foqhn/ekagaku_gritcat/ローバー側　セットアップ方法.md

python packages
```bash

```

ros package
```

```

shell command
```bash
sudo apt install wireless-tools

```
