foqhn/ekagaku_gritcat/説明用/Gritcat_1.0 セットアップ方法.md

## 1. 準備 
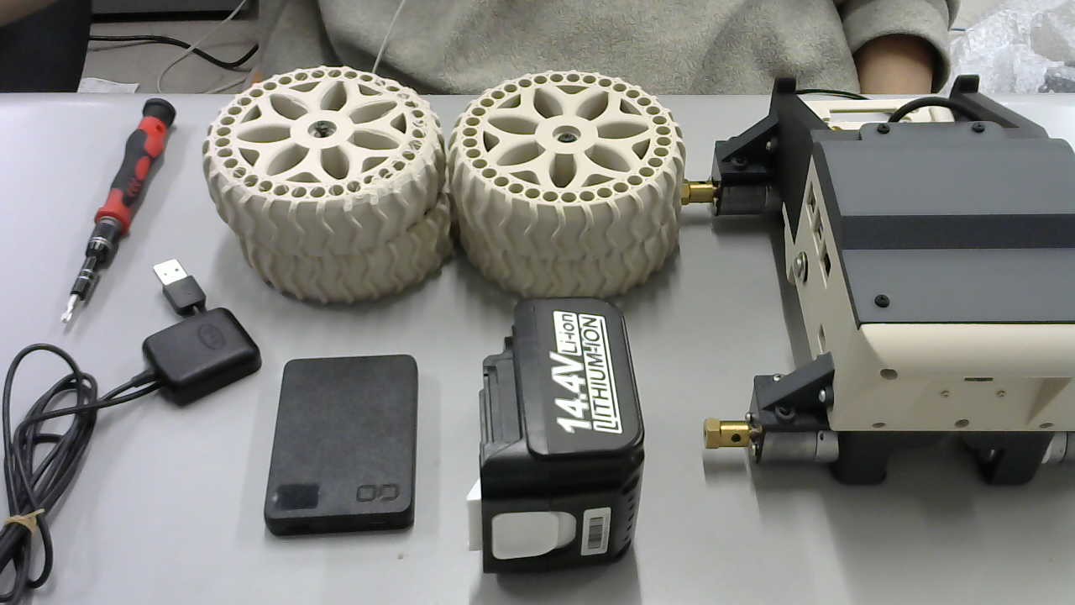
[picture p1: 説明用/images/setup.jpg]

	内容物</br>
	- 本体</br>
	- ホイール x4</br>
	- M4ネジ x4</br>
	- ワッシャー x4</br>
	- マキタ互換バッテリー</br>
	- CIOモバイルバッテリー</br>
	- GPS USBタイプ</br>
	組み立てに必要なもの</br>
	- M4プラスドライバー</br>
	- (M2.5 6角)</br>
## 2. モバイルバッテリーの挿入
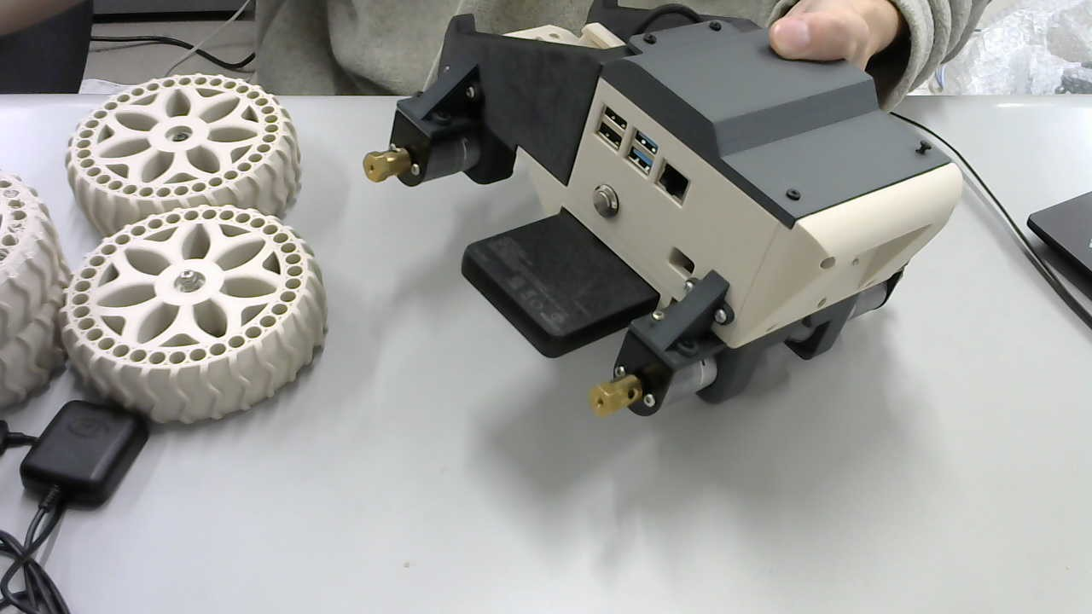
[picture p2: 説明用/images/insert_mob_batt.jpg]

	下のスペースにモバイルバッテリーを**下向きに**挿入する．
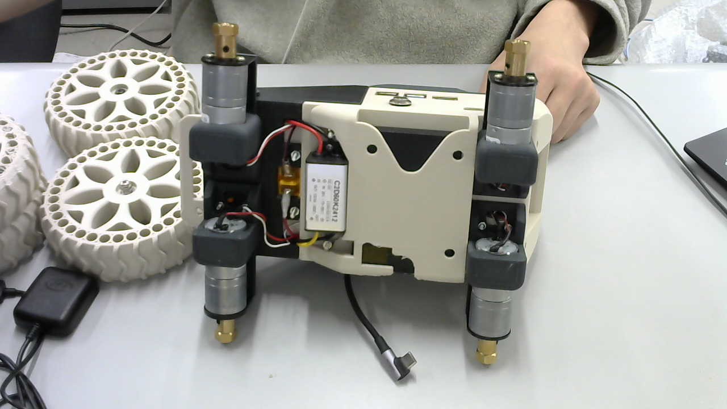
[picture p3: 説明用/images/monitor.jpg]

	バッテリー容量が確認できるモニターがちょうど見えるようになるはず．
## 3. ホイールの取付
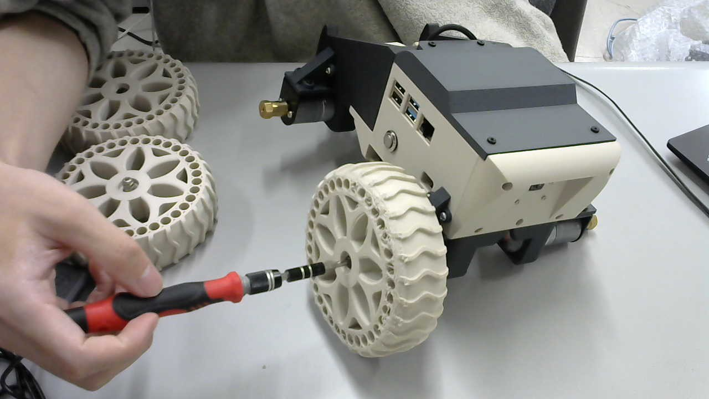
[picture p4: 説明用/images/screw.jpg]

	ネジの頭とホイールの間にワッシャーを挟む
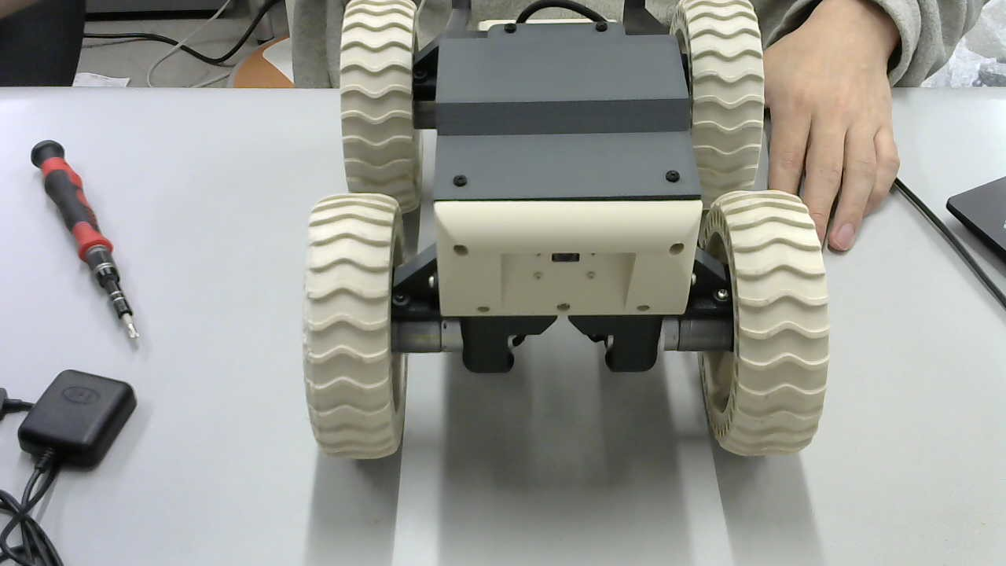
[picture p5: 説明用/images/4wheel.jpg]

	左右でホイールのパターンをそろえたほうがいい
## 4. GPSの取付
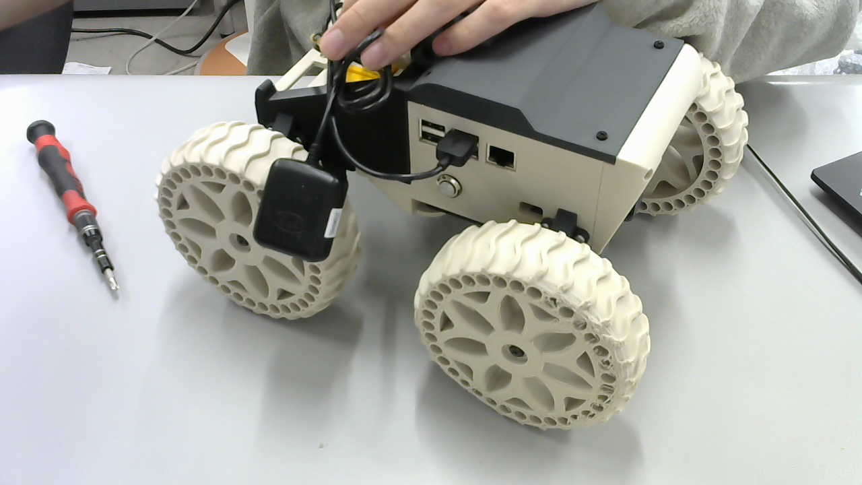
[picture p6: 説明用/images/gps.jpg]

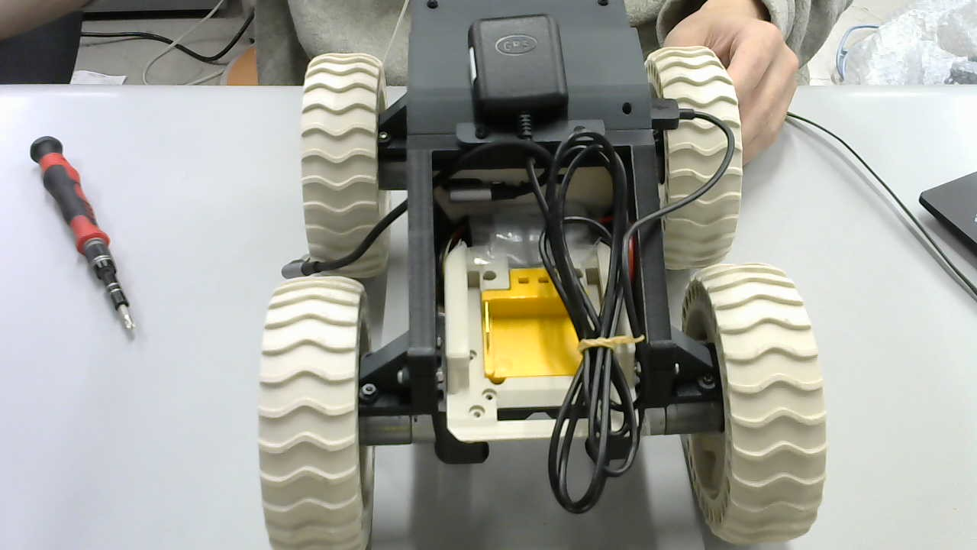
[picture p7: 説明用/images/bind_gps.jpg]

	現状GPSの取付スペースがないので，ケーブルの間に通して固定する
## 5. モーター用バッテリーの挿入
	挿入の前に，本体側面の**ボタンが押下されていない**ことを確認
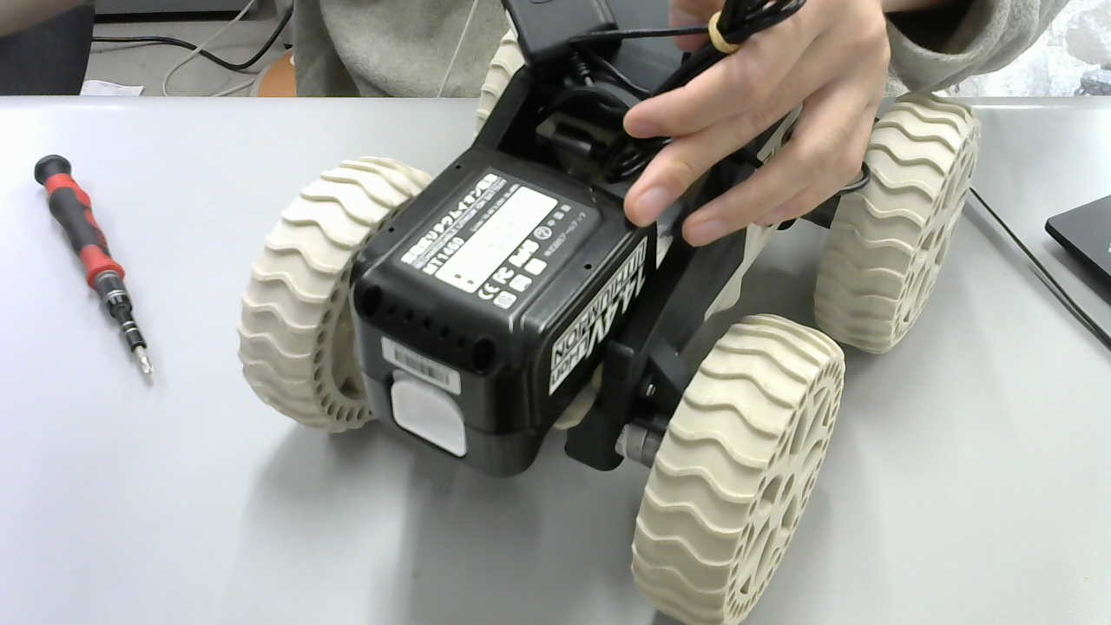
[picture p8: 説明用/images/ins_batt.jpg]

	バッテリーの溝に合わせてスライドするように挿入する．
	カチッと言うまでバッテリーを押し込む．
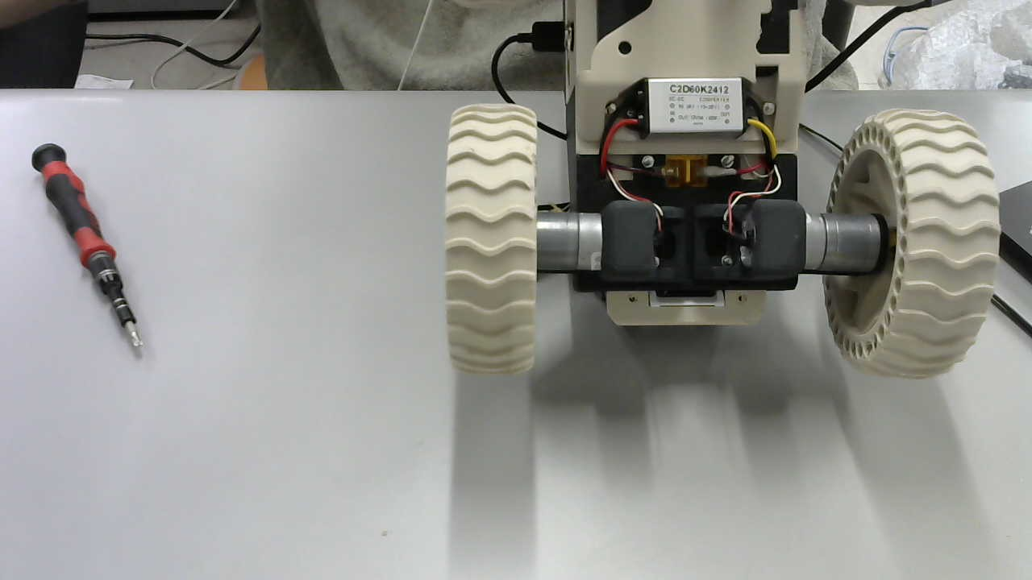
[picture p9: 説明用/images/batt_lock.jpg]

	白い部分がバッテリー取付スペースの穴から完全に出れば固定できている．
## 6. 電源投入
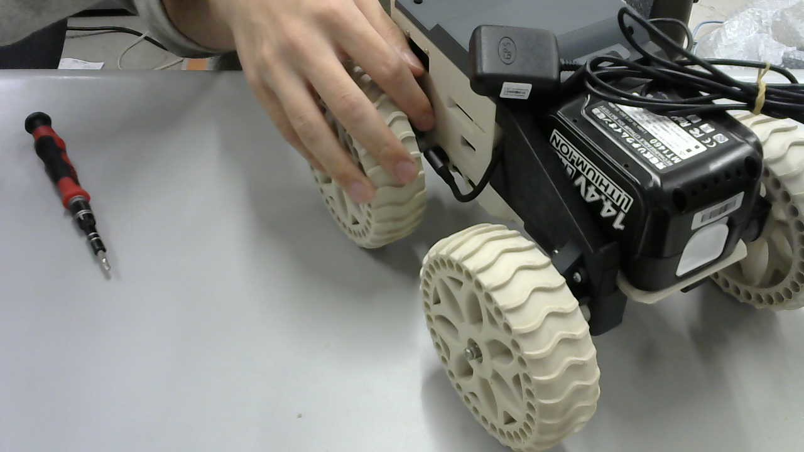
[picture p10: 説明用/images/ins_c.jpg]

	TypeCコネクタをモバイルバッテリーに差し込む．
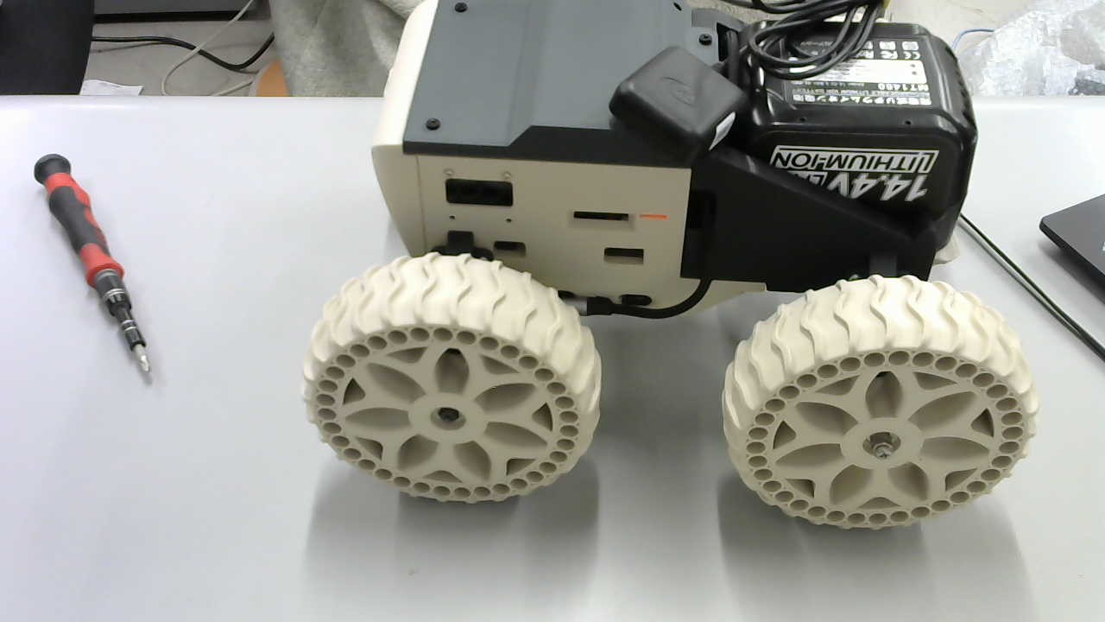
[picture p11: 説明用/images/turnon.jpg]

	赤いランプが点灯することを確認
## 7. システム起動の確認 
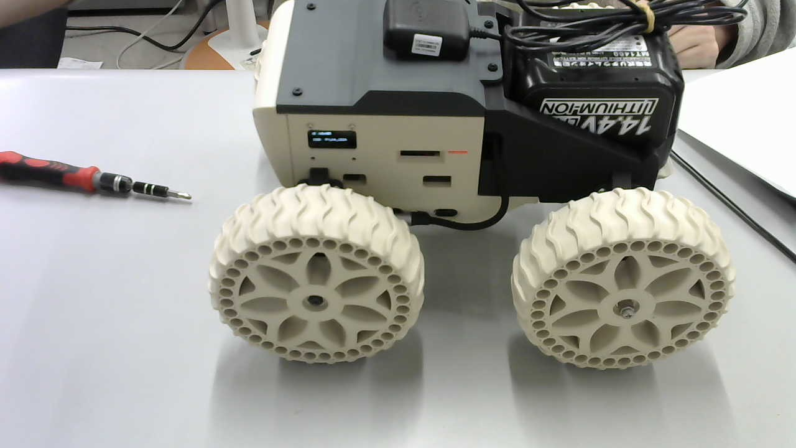
[picture p12: 説明用/images/oledmonitor.jpg]

	電源投入後，5分ほどするとモニターにIDと現在接続されているWifiのSSIDが表示される．
	システムが正常に起動したことを示す．
## 8. モーター用スイッチの押下
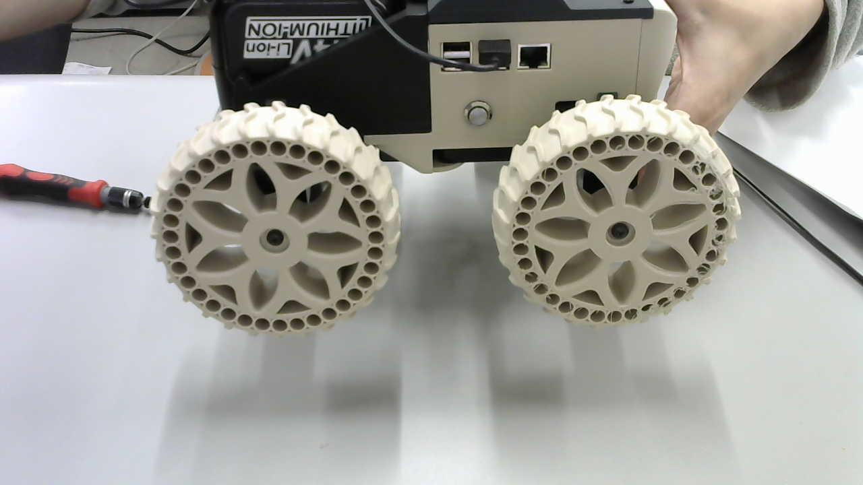
[picture p13: 説明用/images/mt_btn.jpg]
