foqhn/ekagaku_gritcat/Retriever1_mother/Retriever1_mother.step

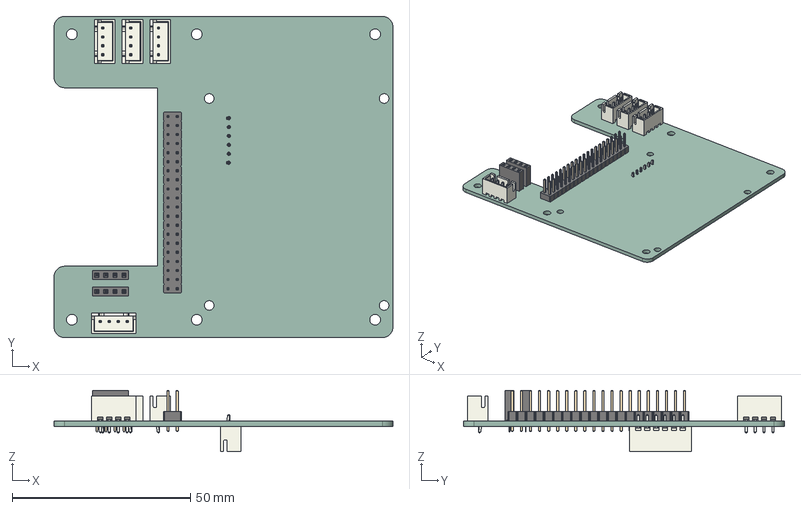
[picture p14: CAD file, 2025-11-23]
Retriever1_mother/Retriever1_mother.step
95.0 x 90.0 x 17.2 mm
PinSocket_1x04_P2.54mm_Vertical x 2
PinHeader_2x20_P2.54mm_Vertical
JST_XH_B4B-XH-A_1x04_P2.50mm_Vertical x 4
JST_XH_B6B-XH-A_1x06_P2.50mm_Vertical
Retriever1_mother_PCB
