foqhn/ekagaku_gritcat/Retriever1_mother/Wheel1.3mf

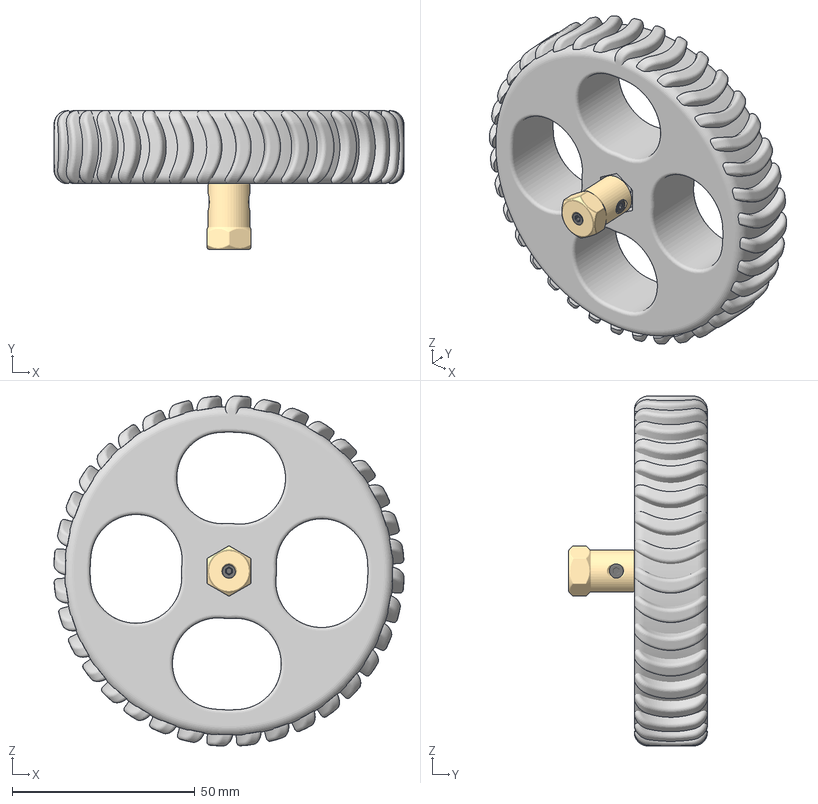
[picture p15: CAD file, 2025-11-23]
Retriever1_mother/Wheel1.3mf
95.9 x 38.0 x 95.9 mm
ボディ1 x 5
