foqhn/ekagaku_gritcat/Retriever1_mother/Retriever1_mother.kicad_pcb

## KiCad design Retriever1_mother/Retriever1_mother.kicad_pcb (2025-11-23)

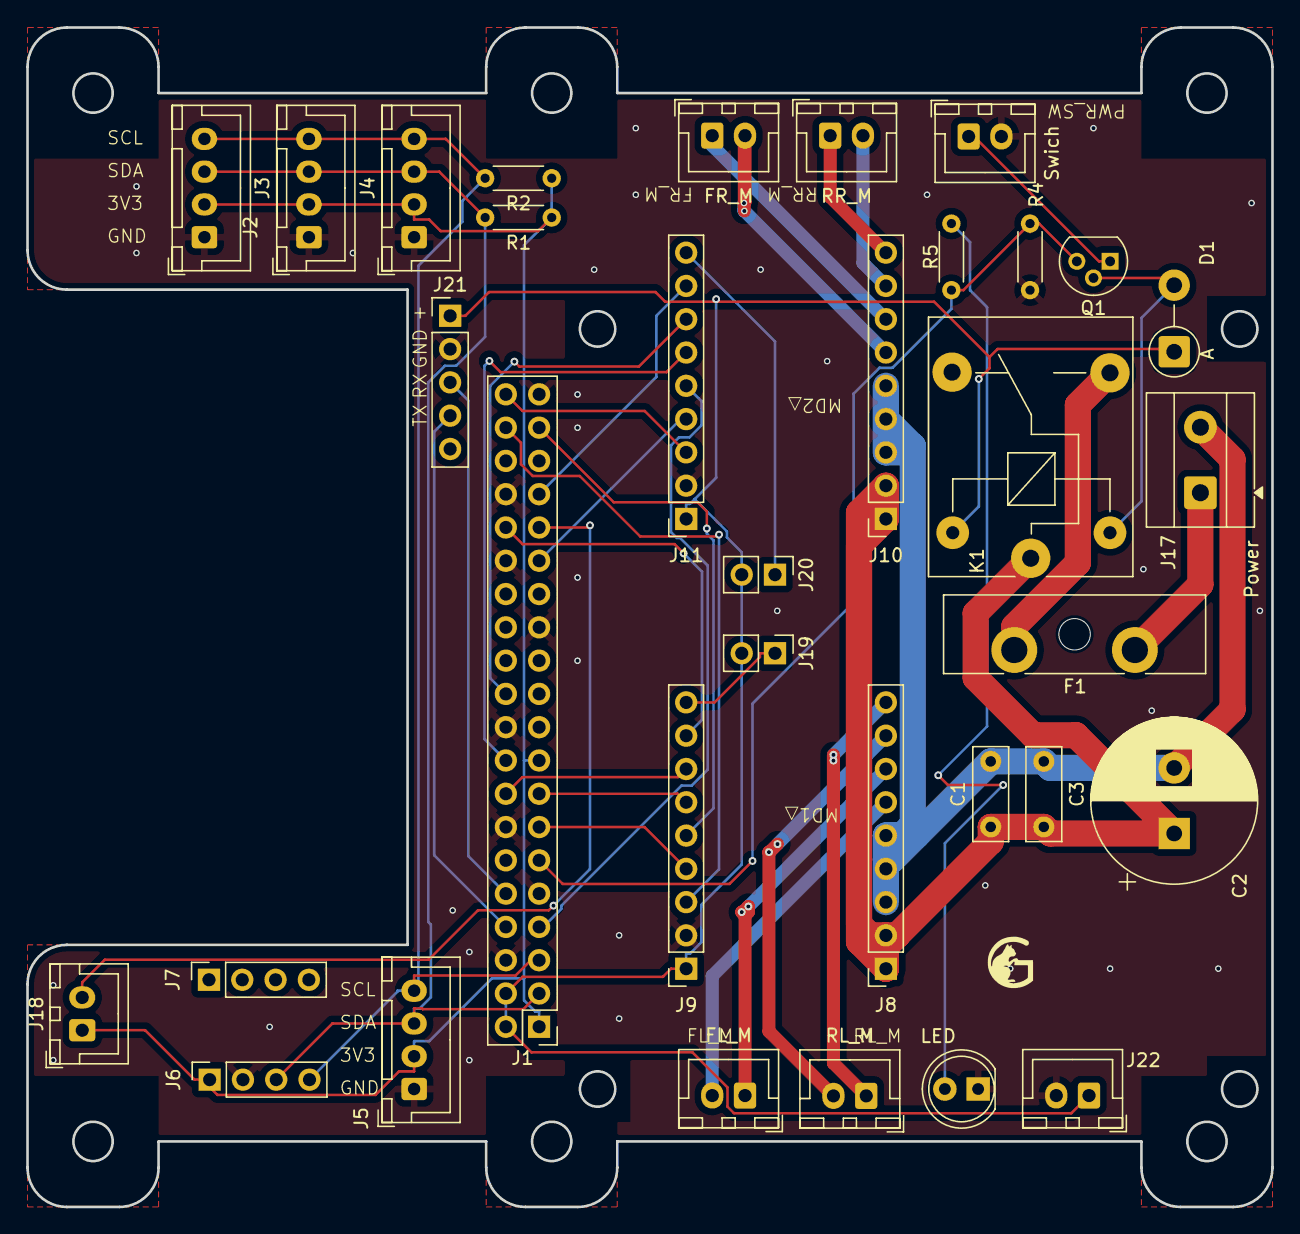
[picture p16: board Retriever1_mother.kicad_pcb from above]

Board: 2 copper layers, 95.0 x 90.0 mm, 34 parts (0 on the bottom side), 38 nets.

Parts:
C1, C3: C; C_Disc_D7.0mm_W2.5mm_P5.00mm
C2: 100uF; CP_Radial_D12.5mm_P5.00mm
D1: D; D_DO-15_P5.08mm_Vertical_AnodeUp
D2: LED; LED_D5.0mm
F1: Fuse; Fuseholder_Blade_ATO_Littelfuse_Pudenz_2_Pin
J1: Raspberry_Pi_4; PinHeader_2x20_P2.54mm_Vertical
J2, J3, J4, J5: Conn_01x04_Pin; JST_XH_B4B-XH-A_1x04_P2.50mm_Vertical
J6, J7: Conn_01x04_Pin; PinSocket_1x04_P2.54mm_Vertical
J8, J9, J10, J11: Conn_01x09_Pin; PinSocket_1x09_P2.54mm_Vertical
J12: FL_M; JST_XH_B2B-XH-A_1x02_P2.50mm_Vertical
J13: FR_M; JST_XH_B2B-XH-A_1x02_P2.50mm_Vertical
J14: RL_M; JST_XH_B2B-XH-A_1x02_P2.50mm_Vertical
J15: RR_M; JST_XH_B2B-XH-A_1x02_P2.50mm_Vertical
J16: Swich; JST_XH_B2B-XH-A_1x02_P2.50mm_Vertical
J17: Power; TerminalBlock_MetzConnect_Type055_RT01502HDWU_1x02_P5.00mm_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
J18, J22: Conn_01x02_Pin; JST_XH_B2B-XH-A_1x02_P2.50mm_Vertical
J19, J20: Conn_01x02_Pin; PinHeader_1x02_P2.54mm_Vertical
J21: Conn_01x05_Pin; PinHeader_1x05_P2.54mm_Vertical
K1: SANYOU_SRD_Form_C; Relay_SPDT_SANYOU_SRD_Series_Form_C
Q1: NPN; TO-92
R1, R2: 10k; R_Axial_DIN0204_L3.6mm_D1.6mm_P5.08mm_Horizontal
R4: 470; R_Axial_DIN0204_L3.6mm_D1.6mm_P5.08mm_Horizontal
R5: 200; R_Axial_DIN0204_L3.6mm_D1.6mm_P5.08mm_Horizontal

Connections:
+3.3V: J1.1 (3V3), J1.17 (3V3), J2.2, J3.2, J4.2, J5.2, J6.1, J18.1, R1.1, R2.1
+5V: D1.1 (K), J1.2 (5V), J1.4 (5V), J9.1, J11.1, J19.2, J20.2, J21.1, J22.1, K1.5
+12V: F1.1, J17.1
/TB6612基盤1/AO_1: J10.6, J13.2
/TB6612基盤1/AO_2: J10.7, J13.1
/TB6612基盤1/BO_1: J10.8, J15.2
/TB6612基盤1/BO_2: J10.9, J15.1
/TB6612基盤1/STBY: J11.9, J20.1
/TB6612基盤/AO_1: J8.6, J12.2
/TB6612基盤/AO_2: J8.7, J12.1
/TB6612基盤/BO_1: J8.8, J14.2
/TB6612基盤/BO_2: J8.9, J14.1
/TB6612基盤/STBY: J9.9, J19.1
/TB6612基盤/VM: C1.1, C2.1, C3.1, J8.1, J8.2, J10.1, J10.2, K1.1
Ext_Sw: J1.31 (GPCLK2/GPIO06), J18.2
FL_1: J1.15 (GPIO22/SDIO_CLK), J9.6
FL_2: J1.16 (GPIO23/SDIO_CMD), J9.7
FL_PWM: J1.32 (GPIO12/PWM0), J9.8
FR_1: J1.18 (GPIO24/SDIO_DAT0), J11.6
FR_2: J1.22 (GPIO25/SDIO_DAT1), J11.7
FR_PWM: J1.33 (GPIO13/PWM1), J11.8
GND: D2.1 (K), J1.6 (GND), J1.9 (GND), J1.14 (GND), J1.20 (GND), J1.25 (GND), J1.30 (GND), J1.34 (GND), J1.39 (GND), J2.1, J3.1, J4.1, J5.1, J6.2, J9.2, J11.2, J16.2, J21.2, J22.2, R4.1
GNDPWR: C1.2, C2.2, C3.2, J8.3, J8.4, J8.5, J10.3, J10.4, J10.5, J17.2
unnamed: D1.2 (A), K1.2, Q1.3 (C)
unnamed: D2.2 (A), R5.2
unnamed: F1.2, K1.3
unnamed: J16.1, Q1.2 (E)
RL_1: J1.37 (GPIO26/SDIO_DAT2), J9.5
RL_2: J1.13 (GPIO27/SDIO_DAT3), J9.4
RL_PWM: J1.38 (GPIO20/SPI1_MOSI/PCM_DIN/PWM1), J9.3
RR_1: J1.7 (GPCLK0/GPIO04), J11.5
RR_2: J1.29 (GPCLK1/GPIO05), J11.4
RR_PWM: J1.40 (GPIO21/SPI1_SCLK/PCM_DOUT), J11.3
SCL: J1.5 (SCL_I2C1/GPIO03), J2.4, J3.4, J4.4, J5.4, J6.4, R2.2
SDA: J1.3 (SDA_I2C1/GPIO02), J2.3, J3.3, J4.3, J5.3, J6.3, R1.2
SD_Swich: J1.11 (GPIO17/SPI1_~CE1), Q1.1 (B), R4.2, R5.1
UART1_RX: J1.10 (GPIO15/UART_RXD), J21.3
UART1_TX: J1.8 (GPIO14/UART_TXD), J21.4
